Fasdfghjkl/stm32_rcl/README.md

# stm32_rcl
A rcl bridge for stm32 (trail)
Debug by Keil uVision5
