Fasdfghjkl/stm32_rcl/docs/lcr1.png

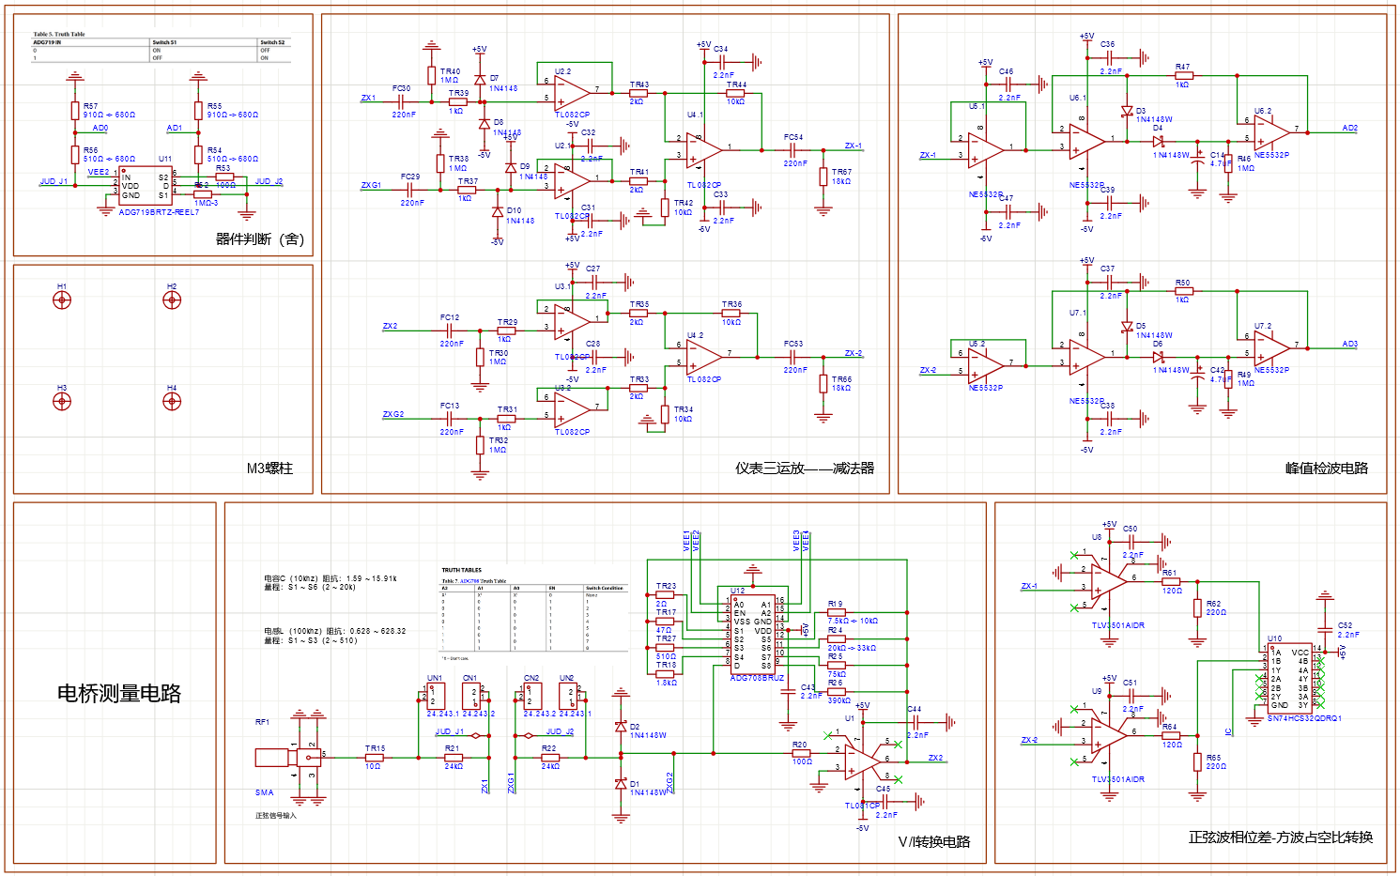
docs/lcr1.png
