Fasdfghjkl/stm32_rcl/docs/power_cont.png

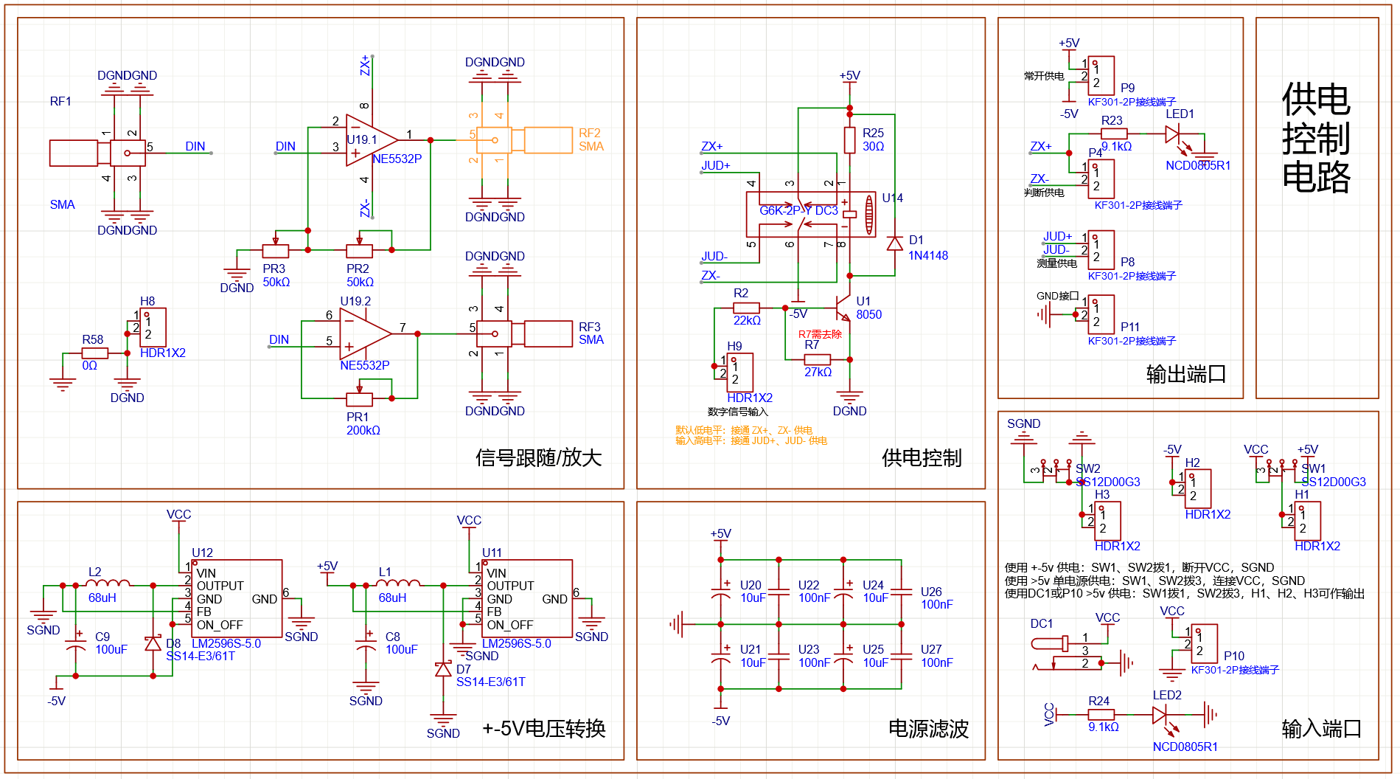
docs/power_cont.png
