Fasdfghjkl/stm32_rcl/docs/wave.png

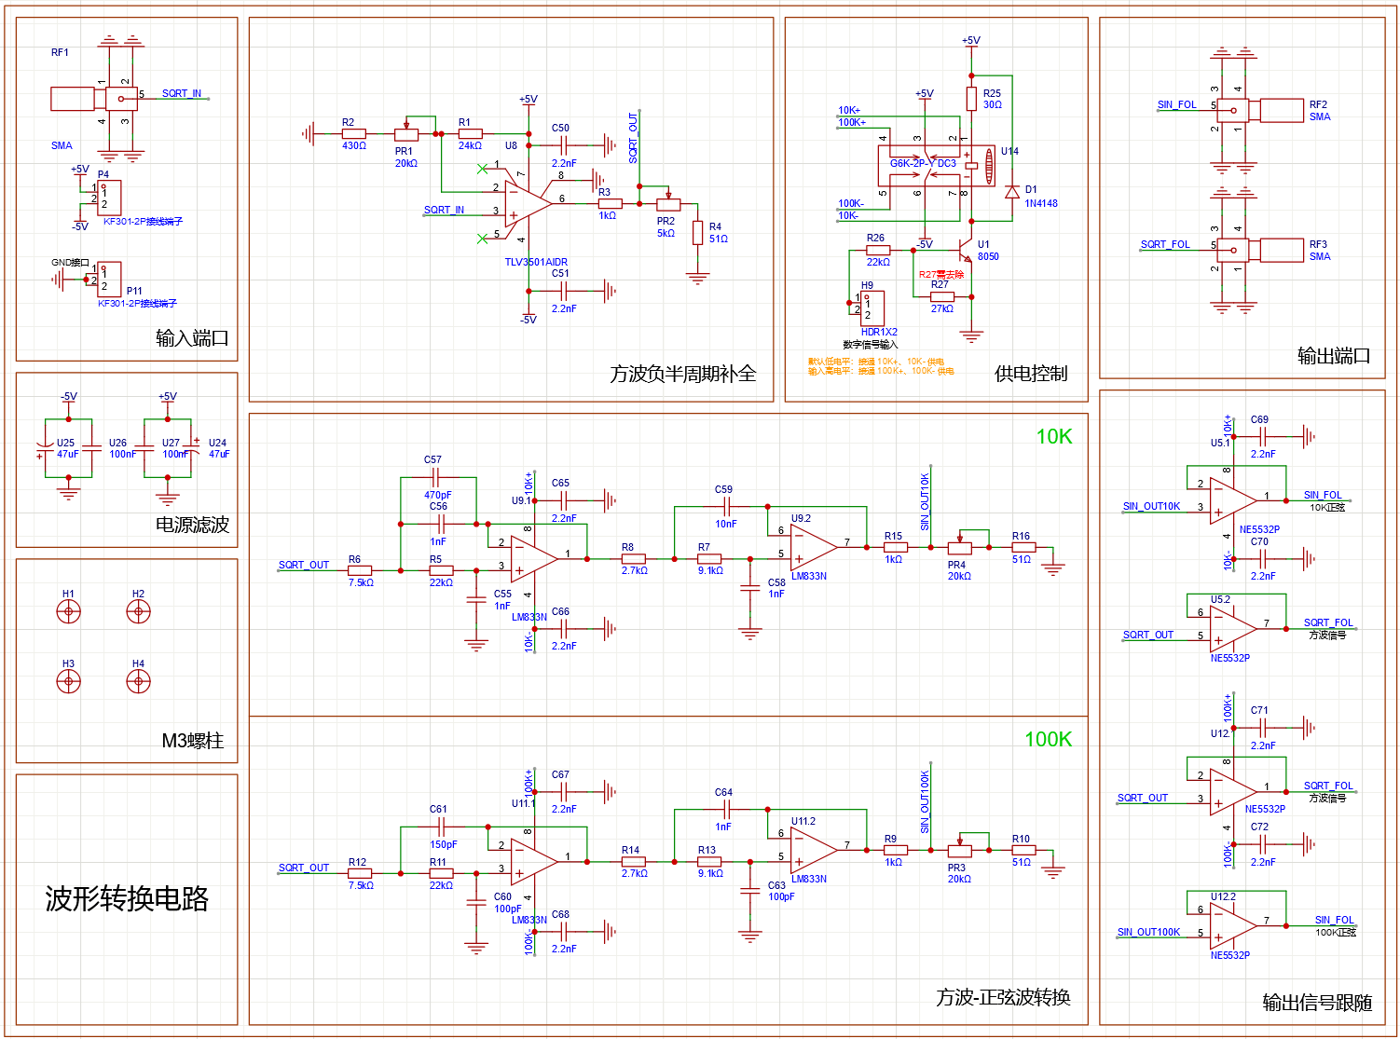
docs/wave.png
