Fasdfghjkl/stm32_rcl/Hardware/KEY.c

#include "stm32f10x.h"                  // Device header
#include "Delay.h"

/** 针脚：GPIOB, GPIO_Pin_1
  * 函    数：按键初始化
  * 参    数：无
  * 返 回 值：无
  */
void KEY_Init(void)
{
	/*开启时钟*/
	RCC_APB2PeriphClockCmd(RCC_APB2Periph_GPIOB, ENABLE);		//开启GPIOB的时钟
	
	/*GPIO初始化*/
	GPIO_InitTypeDef GPIO_InitStructure;
	GPIO_InitStructure.GPIO_Mode = GPIO_Mode_IPU;
	GPIO_InitStructure.GPIO_Pin = GPIO_Pin_1;
	GPIO_InitStructure.GPIO_Speed = GPIO_Speed_50MHz;
	GPIO_Init(GPIOB, &GPIO_InitStructure);						//将PB1引脚初始化为上拉输入
}

/**
  * 函    数：按键获取键码
  * 参    数：无
  * 返 回 值：按下按键的键码值，范围：0~1，返回0代表没有按键按下
  * 注意事项：此函数是阻塞式操作，当按键按住不放时，函数会卡住，直到按键松手
  */
uint8_t KEY_GetNum(void)
{
	uint8_t KEYNum = 0;		//定义变量，默认键码值为0
	
	if (GPIO_ReadInputDataBit(GPIOB, GPIO_Pin_1) == 0)			//读PB1输入寄存器的状态，如果为0，则代表按键1按下
	{
		Delay_ms(20);											//延时消抖
		while (GPIO_ReadInputDataBit(GPIOB, GPIO_Pin_1) == 0);	//等待按键松手
		Delay_ms(20);											//延时消抖
		KEYNum = 1;												//置键码为1
	}
	
	return KEYNum;			//返回键码值，如果没有按键按下，所有if都不成立，则键码为默认值0
}
