Fasdfghjkl/stm32_rcl/Hardware/OLED.h

#ifndef __OLED_H
#define __OLED_H

void OLED_Init(void);
void OLED_Clear(void);
void OLED_ShowChar(uint8_t Line, uint8_t Column, char Char);
void OLED_ShowString(uint8_t Line, uint8_t Column, char *String);
//uint32_t OLED_Pow(uint32_t X, uint32_t Y);
//uint32_t OLED_Numlen(double num, uint16_t flength);
void OLED_ShowNum(uint8_t Line, uint8_t Column, uint32_t Number, uint8_t Length);
void OLED_ShowSignedNum(uint8_t Line, uint8_t Column, int32_t Number, uint8_t Length);
void OLED_ShowFNum(uint8_t Line, uint8_t Column, float Number, uint8_t Length,uint8_t Flength);
void OLED_ShowHexNum(uint8_t Line, uint8_t Column, uint32_t Number, uint8_t Length);
void OLED_ShowBinNum(uint8_t Line, uint8_t Column, uint32_t Number, uint8_t Length);

#endif
