Fasdfghjkl/stm32_rcl/Hardware/VEE.h

#ifndef __VEE_H
#define __VEE_H

void VEE_Init(void);
void VEE1_ON(void);
void VEE1_OFF(void);
void VEE1_Turn(void);
void VEE2_ON(void);
void VEE2_OFF(void);
void VEE2_Turn(void);
void VEE3_ON(void);
void VEE3_OFF(void);
void VEE3_Turn(void);
void VEE4_ON(void);
void VEE4_OFF(void);
void VEE4_Turn(void);
void VEESet(uint8_t VEE1, uint8_t VEE2, uint8_t VEE3, uint8_t VEE4);

#endif
